rajp20/LED_Canvas/document/images/final_product.jpg

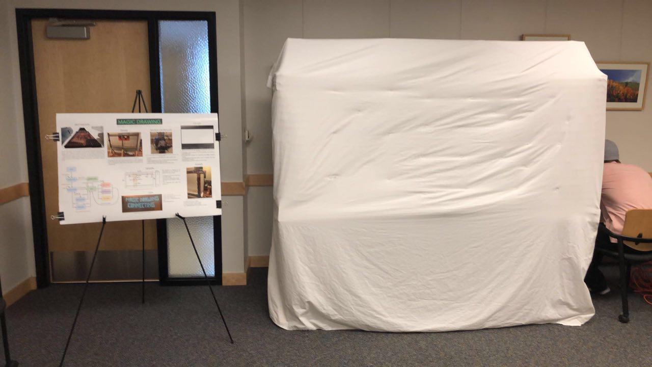
document/images/final_product.jpg
