rajp20/LED_Canvas/document/images/frame_updated.jpg

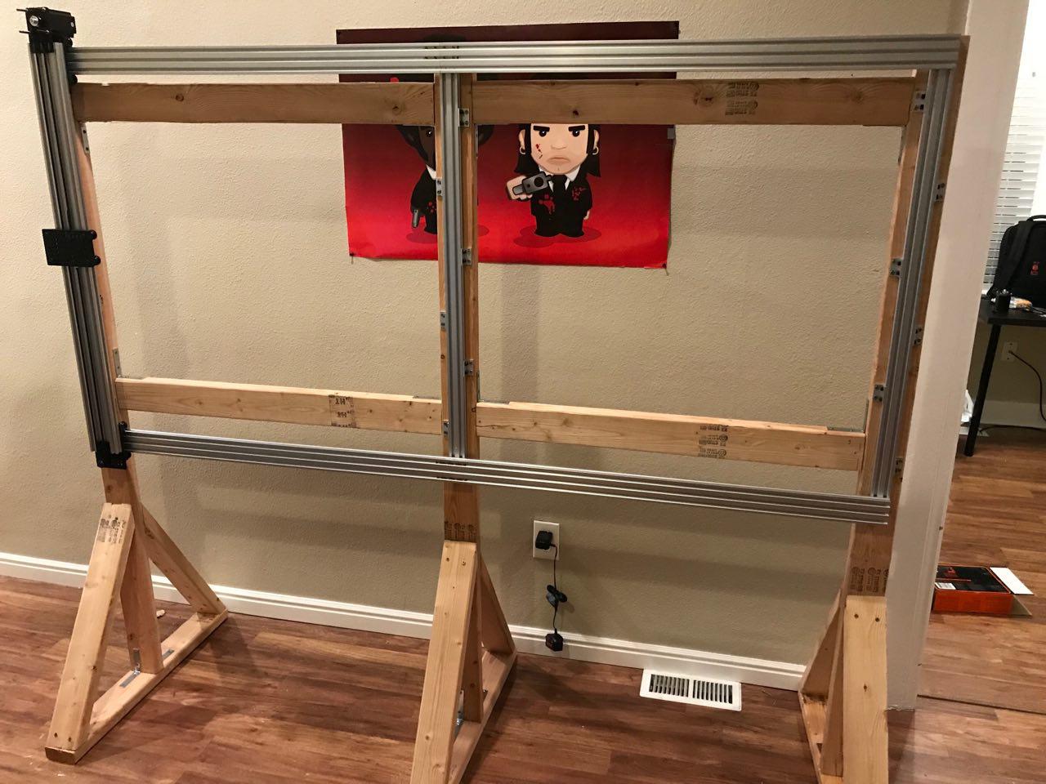
document/images/frame_updated.jpg
