rajp20/LED_Canvas/document/images/led_strips.jpg

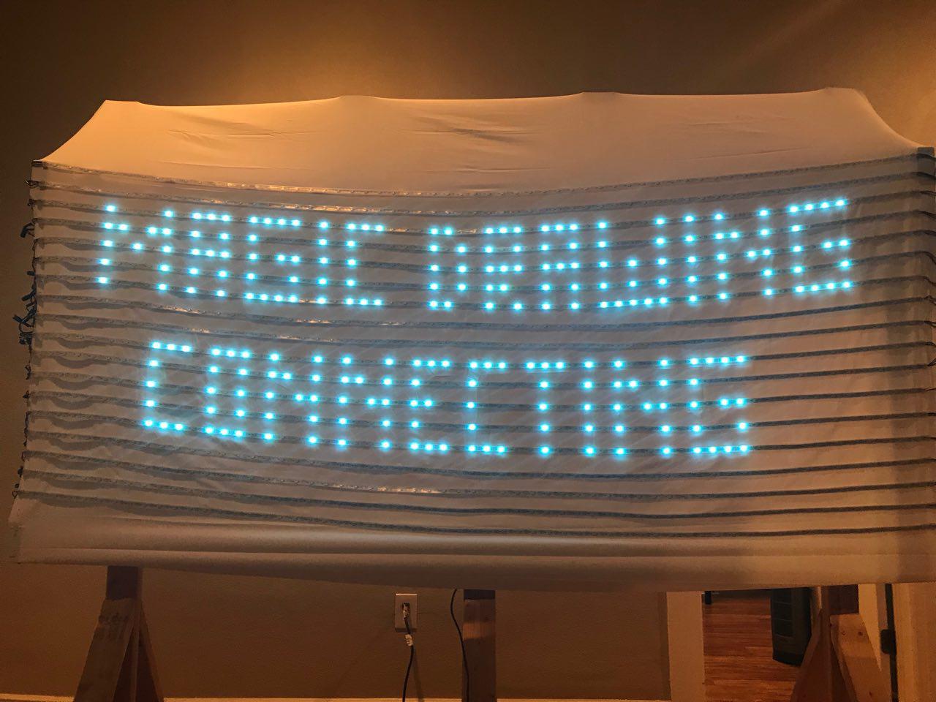
document/images/led_strips.jpg
