rajp20/LED_Canvas/document/images/state_diagram.png

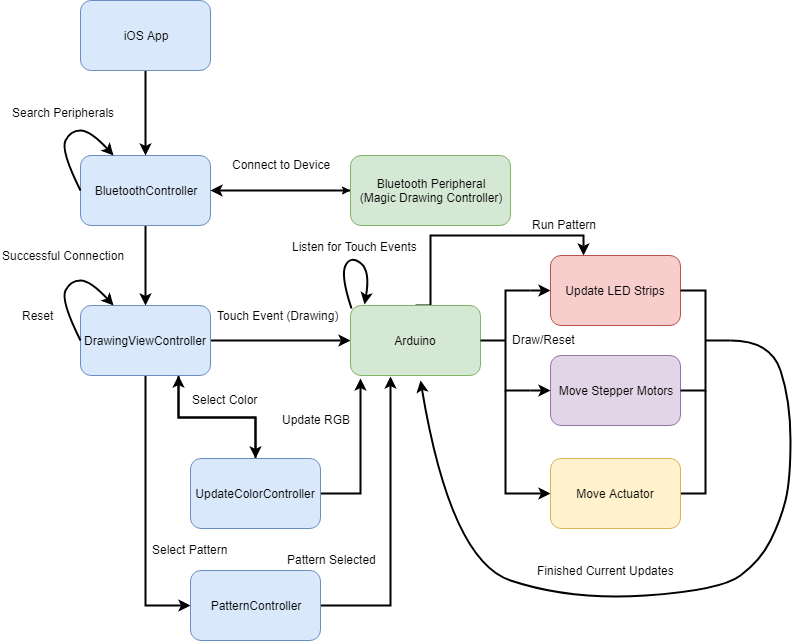
document/images/state_diagram.png
