rajp20/LED_Canvas/PCB_schematics/PCB_board.png

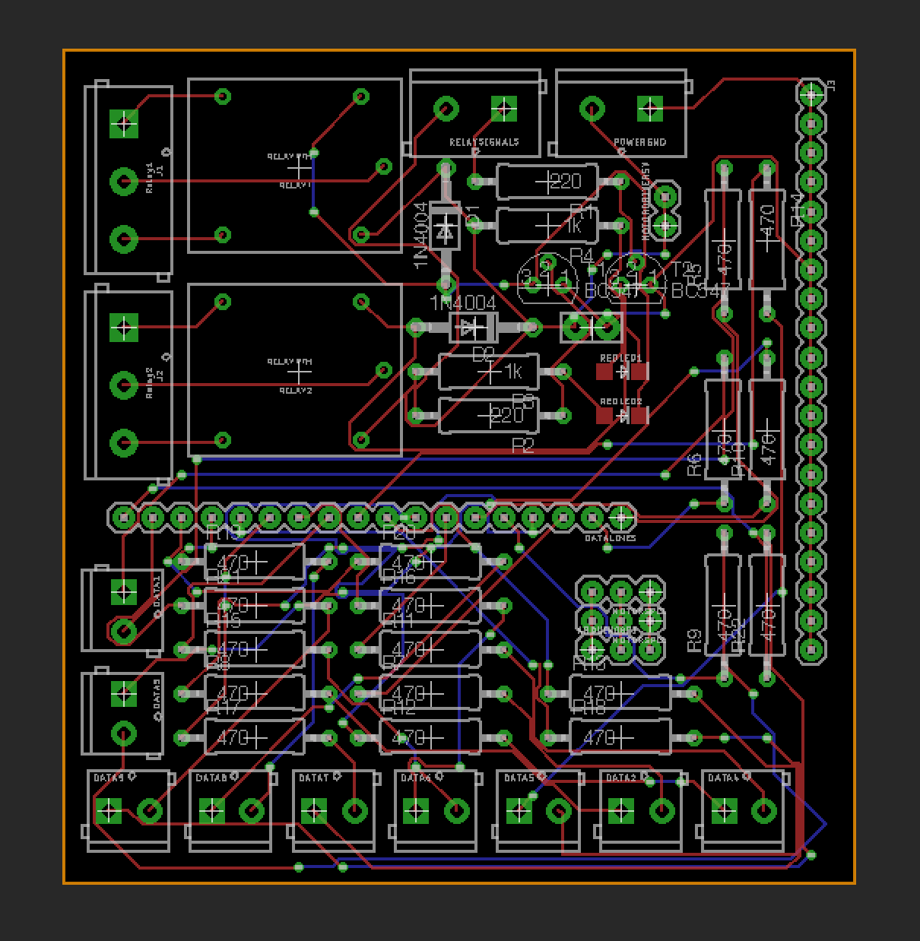
PCB_schematics/PCB_board.png
