rajp20/LED_Canvas/PCB_schematics/Connections and Power.brd

## EAGLE design PCB_schematics/Connections and Power.brd (2018-12-18)

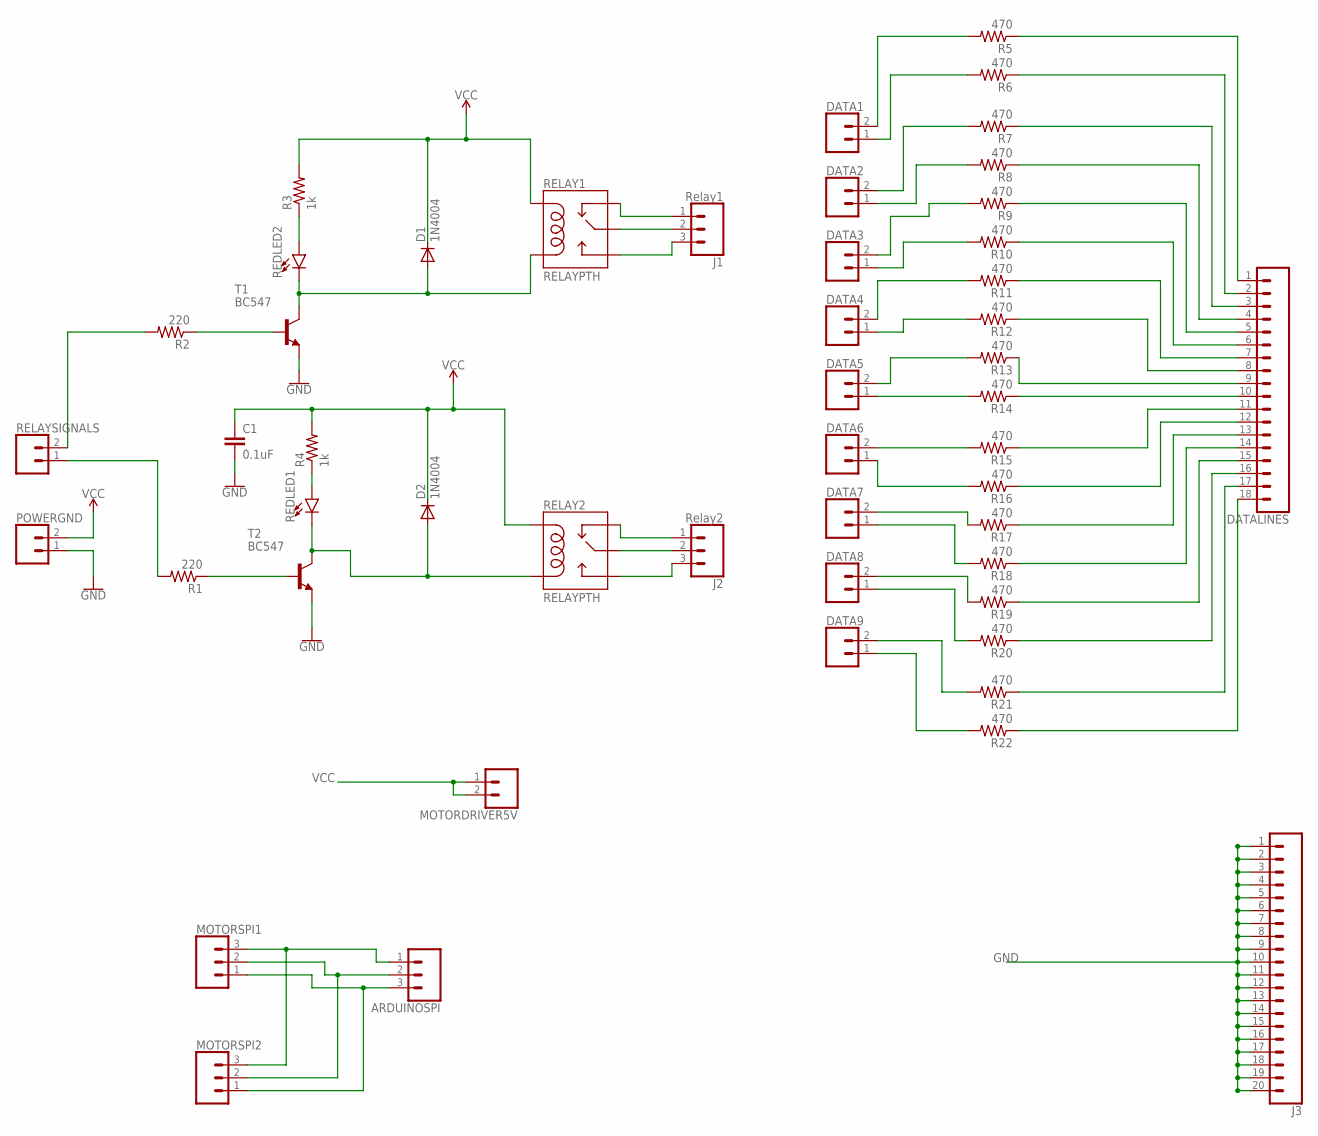
[picture p22: schematic Connections and Power.sch]

Parts:
ARDUINOSPI: CONN_03; 1X03
C1: 0.1uF; CAP-PTH-SMALL-KIT
D1, D2: 1N4004; DO41-10
DATA1, DATA2, DATA3, DATA4, DATA5, DATA6, DATA7, DATA8, DATA9: CONN_023.5MM; SCREWTERMINAL-3.5MM-2
DATALINES: CONN_18; 1X18
J1: Relay1; SCREWTERMINAL-5MM-3
J2: Relay2; SCREWTERMINAL-5MM-3
J3: CONN_20; 1X20
MOTORDRIVER5V: CONN_02; 1X02
MOTORSPI1, MOTORSPI2: CONN_03; 1X03
POWERGND: CONN_025MM; SCREWTERMINAL-5MM-2
R1, R2: 220; 0309/12
R3, R4: 1k; 0309/12
R5, R6, R7, R8, R9, R10, R11, R12, R13, R14, R15, R16, R17, R18, R19, R20, R21, R22: 470; 0309/12
REDLED1, REDLED2: LED1206; LED-1206
RELAY1, RELAY2: RELAYPTH; SRD-05VDC-SL-C
RELAYSIGNALS: CONN_025MM; SCREWTERMINAL-5MM-2
T1, T2: BC547; TO92

Connections:
GND: C1.2, J3.1, J3.2, J3.3, J3.4, J3.5, J3.6, J3.7, J3.8, J3.9, J3.10, J3.11, J3.12, J3.13, J3.14, J3.15, J3.16, J3.17, J3.18, J3.19, J3.20, POWERGND.1, T1.1 (E), T2.1 (E)
unnamed: DATA1.2, R5.2
unnamed: D2.A, REDLED1.C, RELAY2.COIL0, T2.3 (C)
unnamed: R4.1, REDLED1.A
unnamed: R2.2, RELAYSIGNALS.2
unnamed: J2.1, RELAY2.SWCLOSED (SWCLOSE)
unnamed: J2.2, RELAY2.SWCOMMON
unnamed: J2.3, RELAY2.SWOPEN
unnamed: R1.1, T2.2 (B)
unnamed: R2.1, T1.2 (B)
unnamed: D1.A, REDLED2.C, RELAY1.COIL0, T1.3 (C)
unnamed: R3.1, REDLED2.A
unnamed: DATA1.1, R6.2
unnamed: J1.1, RELAY1.SWCLOSED (SWCLOSE)
unnamed: J1.2, RELAY1.SWCOMMON
unnamed: J1.3, RELAY1.SWOPEN
unnamed: R1.2, RELAYSIGNALS.1
unnamed: DATA2.2, R7.2
unnamed: DATA2.1, R8.2
unnamed: DATA3.2, R9.2
unnamed: DATA3.1, R10.2
unnamed: DATA4.2, R11.2
unnamed: DATA4.1, R12.2
unnamed: DATA5.2, R13.2
unnamed: DATA5.1, R14.2
unnamed: DATA6.2, R15.2
unnamed: DATA6.1, R16.2
unnamed: DATA7.2, R17.2
unnamed: DATA7.1, R18.2
unnamed: DATA8.2, R19.2
unnamed: DATA8.1, R20.2
unnamed: DATA9.2, R21.2
unnamed: DATA9.1, R22.2
unnamed: DATALINES.18, R22.1
unnamed: DATALINES.17, R21.1
unnamed: DATALINES.16, R20.1
unnamed: DATALINES.15, R19.1
unnamed: DATALINES.14, R18.1
unnamed: DATALINES.13, R17.1
unnamed: DATALINES.12, R16.1
unnamed: DATALINES.11, R15.1
unnamed: DATALINES.10, R14.1
unnamed: DATALINES.1, R5.1
unnamed: DATALINES.2, R6.1
unnamed: DATALINES.3, R7.1
unnamed: DATALINES.4, R8.1
unnamed: DATALINES.5, R9.1
unnamed: DATALINES.6, R10.1
unnamed: DATALINES.7, R11.1
unnamed: DATALINES.8, R12.1
unnamed: DATALINES.9, R13.1
unnamed: ARDUINOSPI.1, MOTORSPI1.3, MOTORSPI2.3
unnamed: ARDUINOSPI.2, MOTORSPI1.2, MOTORSPI2.2
unnamed: ARDUINOSPI.3, MOTORSPI1.1, MOTORSPI2.1
VCC: C1.1, D1.C, D2.C, MOTORDRIVER5V.1, MOTORDRIVER5V.2, POWERGND.2, R3.2, R4.2, RELAY1.COIL1, RELAY2.COIL1

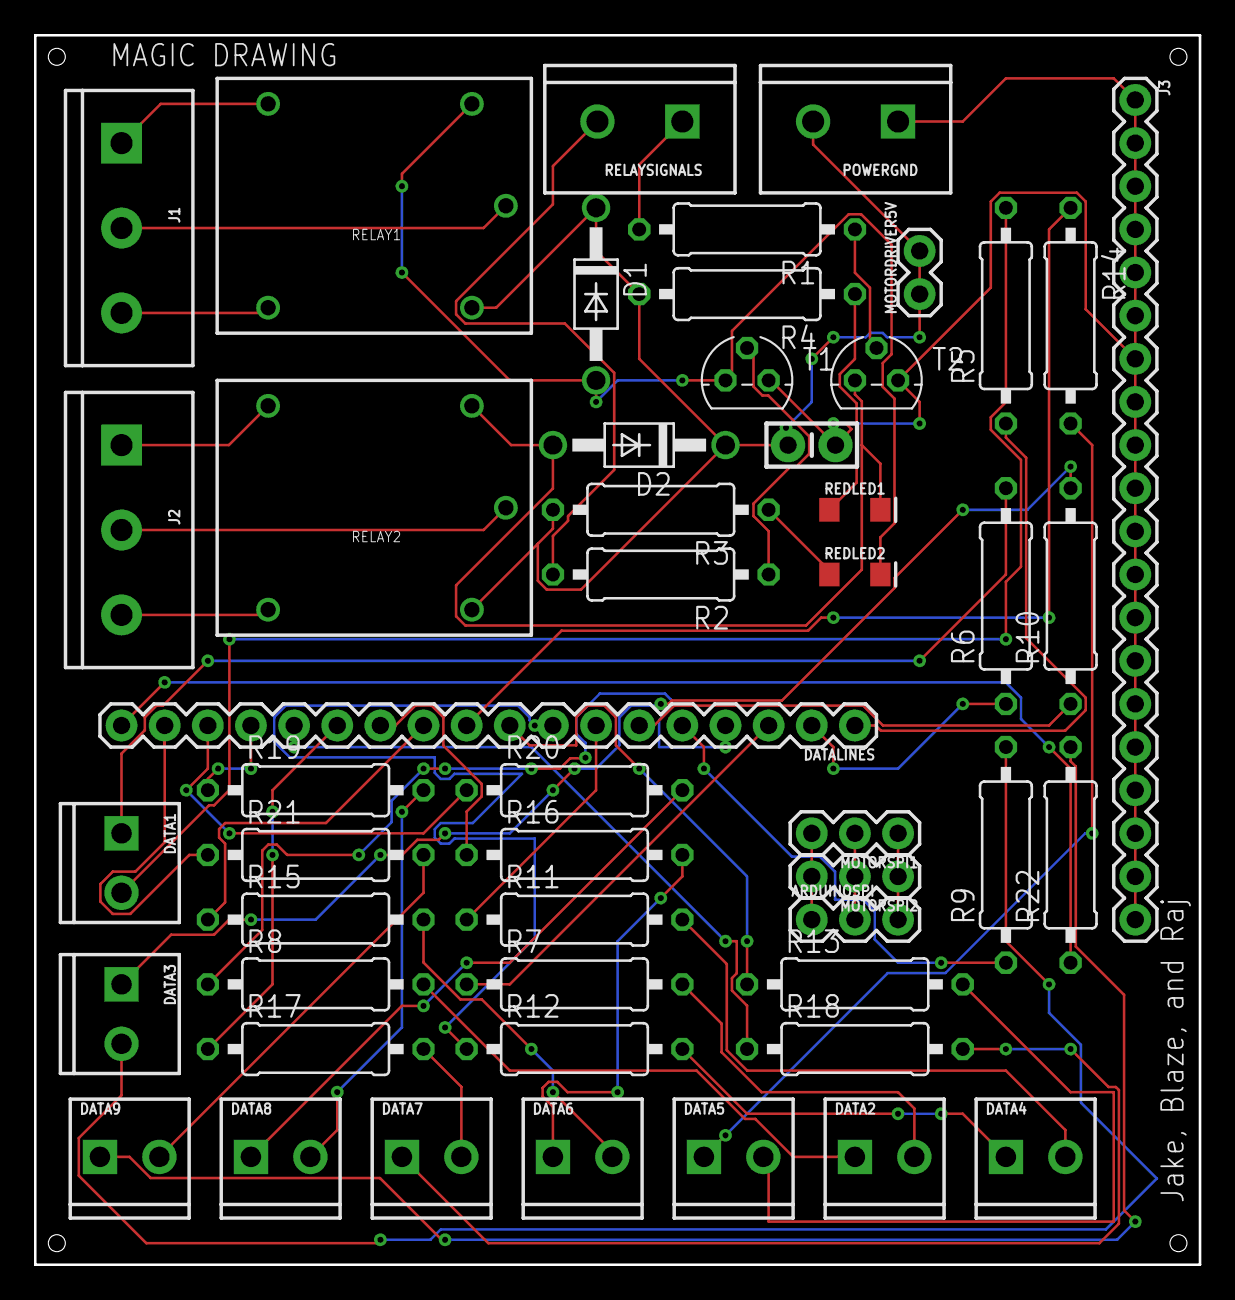
[picture p23: board Connections and Power.brd from above]

Board: 2 copper layers, 68.6 x 72.4 mm, 50 parts (0 on the bottom side), 55 nets.
