rajp20/LED_Canvas/Arduino/Uno_Motor/MotorController.ino

void MotorController::setup(void) {
  setupLimitSwitches();
  setupMotors();
  setupActuator();
  calibrate();
}

/**
   Sets up the X and Y limit switches pins.
*/
void MotorController::setupLimitSwitches(void) {
  pinMode(A0, INPUT);
  pinMode(A1, INPUT);
}

/**
   Sets up the pins for the actuator.
*/
void MotorController::setupActuator(void) {
  pinMode(ACTUATOR_UP, OUTPUT);
  pinMode(ACTUATOR_DOWN, OUTPUT);
  actuatorDown();
}

/**
   Configures the SPI connection and the motor settings for the X and Y motors.
*/
void MotorController::setupMotors(void) {
  SPI.begin();

  // Underlying motor initializiation
  x_motor.init(X_MOTOR_SLAVESELECT);
  y_motor.init(Y_MOTOR_SLAVESELECT);
  delay(1);

  // Drive the NXT/STEP and DIR pins low initially.
  digitalWrite(X_MOTOR_STEP, LOW);
  pinMode(X_MOTOR_STEP, OUTPUT);
  digitalWrite(X_MOTOR_DIR, LOW);
  pinMode(X_MOTOR_DIR, OUTPUT);

  digitalWrite(Y_MOTOR_STEP, LOW);
  pinMode(Y_MOTOR_STEP, OUTPUT);
  digitalWrite(Y_MOTOR_DIR, LOW);
  pinMode(Y_MOTOR_DIR, OUTPUT);

  x_motor.resetSettings();
  x_motor.setCurrentMilliamps(1800);
  x_motor.setStepMode(1);
  x_motor.enableDriver();

  y_motor.resetSettings();
  y_motor.setCurrentMilliamps(1800);
  y_motor.setStepMode(1);
  y_motor.enableDriver();
}

/**
   Bring the motors to home position. Also makes the actuator
   go up and down to check if it is working properly.
*/
void MotorController::calibrate(void) {
  setDirection(X_MOTOR, LEFT);
  setDirection(Y_MOTOR, UP);

  bool x_done = digitalRead(A0) == LOW;
  bool y_done = digitalRead(A1) == LOW;

  while (true) {
    
    if (!x_done) {
      step(X_MOTOR);
    }
    if (!y_done) {
      //      Serial.println("step y");
      step(Y_MOTOR);
    }
    x_done = digitalRead(A0) == LOW;
    y_done = digitalRead(A1) == LOW;
    if (x_done && y_done) {
      break;
    }
  }
  //  actuatorDown();
}

/**
   Sends a pulse on the NXT/STEP pin to tell the driver to take
   one step, and also delays to control the speed of the motor.
*/
void MotorController::step(bool motor)
{
  if (motor) {
    // The NXT/STEP minimum high pulse width is 2 microseconds.
    digitalWrite(X_MOTOR_STEP, HIGH);
    delayMicroseconds(3);
    digitalWrite(X_MOTOR_STEP, LOW);
    delayMicroseconds(3);
  }
  else {
    // The NXT/STEP minimum high pulse width is 2 microseconds.
    digitalWrite(Y_MOTOR_STEP, HIGH);
    delayMicroseconds(3);
    digitalWrite(Y_MOTOR_STEP, LOW);
    delayMicroseconds(3);
  }


  // The delay here controls the stepper motor's speed.  You can
  // increase the delay to make the stepper motor go slower.  If
  // you decrease the delay, the stepper motor will go fast, but
  // there is a limit to how fast it can go before it starts
  // missing steps.
  delayMicroseconds(1500);
}

/**
   Write a high or low value to the direction pin to specify
   what direction to turn the motor.
*/
// Writes a high or low value to the direction pin to specify
// what direction to turn the motor.
void MotorController::setDirection(bool motor, bool dir)
{
  if (motor) {
    // The NXT/STEP pin must not change for at least 0.5
    // microseconds before and after changing the DIR pin.
    delayMicroseconds(1);
    digitalWrite(X_MOTOR_DIR, dir);
    delayMicroseconds(1);
  }
  else {
    // The NXT/STEP pin must not change for at least 0.5
    // microseconds before and after changing the DIR pin.
    delayMicroseconds(1);
    digitalWrite(Y_MOTOR_DIR, dir);
    delayMicroseconds(1);
  }
}

/**
   Brings the actuator all the way out.
*/
void MotorController::actuatorUp(void) {
  digitalWrite(ACTUATOR_UP, HIGH);
  digitalWrite(ACTUATOR_DOWN, LOW);
}

/**
   Brings the actuator all the way in.
*/
void MotorController::actuatorDown(void) {
  digitalWrite(ACTUATOR_DOWN, HIGH);
  digitalWrite(ACTUATOR_UP, LOW);
}

/**
 * Stops the actuator from coming out or coming in
 */
void MotorController::stopActuator(void){
  digitalWrite(ACTUATOR_DOWN, LOW);
  digitalWrite(ACTUATOR_UP, LOW);
}

/*
  Move the motor to the new position
*/
void MotorController::move(int x, int y) {

  // Bound the x-axis
  if (x < 0) {
    x = 0;
  }
  if (x > 57) {
    x = 57;
  }

  // Bound the y-axis
  if (y < 0) {
    y = 0;
  }
  if (y > 17) {
    y = 17;
  }

  // Calculate the number of positions we need to move
  int numberOfXSteps = x - curX;
  int numberOfYSteps = y - curY;

  bool xDirection;
  bool yDirection;

  // Determine what direction the motors need to go
  if (numberOfXSteps < 0) {
    xDirection = LEFT;

    // Make it positive for next calculations
    numberOfXSteps *= -1;
  }
  else {
    xDirection = RIGHT;
  }

  if (numberOfYSteps < 0) {
    yDirection = UP;

    // Make it positive for next calculations
    numberOfYSteps *= -1;
  }
  else {
    yDirection = DOWN;
  }

  // Set the new directions
  setDirection(X_MOTOR, xDirection);
  setDirection(Y_MOTOR, yDirection);

  numberOfXSteps *= STEP_X;
  numberOfYSteps *= STEP_Y;


  while (numberOfXSteps > 0 ||  numberOfYSteps > 0) {
    if (numberOfXSteps > 0) {
      step(X_MOTOR);
      numberOfXSteps--;
    }
    if (numberOfYSteps > 0) {
      step(Y_MOTOR);
      numberOfYSteps--;
    }
  }

  curY = y;
  curX = x;

}
