rajp20/LED_Canvas/(commit log)

2018-09-13 Added Arduino project
2018-09-18 added led controller
2018-09-18 Added four buttons to toggle colors of leds
2018-10-23 Drawing view controller (UARTModuleViewController) now draws line segments
2018-11-03 Drawing view added and working with skip button on main
2018-11-03 added controller for motor
2018-11-03 BT now sending data at full capacity
2018-11-06 added 18 led strip config
2018-11-09 Added basic motor code.
2018-11-11 Began making custom class for menu bar at bottom of screen. Currently unable to connect UICollectionView to custom class
2018-11-24 Custom menu bar is now visible to the UARTModuleViewController
2018-11-25 Several ways in which MenuCell's can open options menu and will need to decide on one. Fixed clear button.
2018-11-25 working on motor class
2018-11-25 Created segue between UARTViewController and Color selction. Bugs exist between segue such as navigation bar disapears.
2018-11-25 updated motor controller
2018-11-26 added 'resetting' screen to LED controller and added ability to send packet to the iOS app.
    [BluetoothController.cpp, BluetoothController.h, LEDController.cpp, LEDController.h]
2018-11-26 Segues & corresponding view controllers added for Patterns and Filters
2018-11-27 Updates to labels, MenuCell padding, and reset button
2018-11-27 Added action to reset button on touch event. Apply button returns to UARTModuleViewController from ColorController
2018-11-28 fixed welcome and reset screens and added rainbow pixel test
    [Canvas.ino, LEDController.cpp, LEDController.h]
2018-11-30 added actuator stuff
2018-12-03 added led clearing
2018-12-03 motors calibrated
2018-12-03 Fixed draw ball I think.
    [LEDController.ino]
2018-12-04 updated LED controller
2018-12-05 Added images to the buttons in UARTModuleViewController
2018-12-05 Reset button works now.
2018-12-05 Pattern button for ball added
2018-12-05 Updated commands, added pattern buttons, tweaked resets. Bug remains in reset
2018-12-06 Fixed double connection errors.
    [BluetoothController.h, BluetoothController.ino, Canvas.ino]
2018-12-06 New button for Life pattern
2018-12-06 bug fixes, added fade to ripple, change conway, and added motor movement
    [Canvas.ino, LEDController.h, LEDController.ino, MotorController.ino]
2018-12-06 motors working, added drawBox for pixels, and added fade for draw
2018-12-07 UI updates, button configurations in PatternController
2018-12-07 bug fixes and removed interrupts
    [BluetoothController.ino, Canvas.ino, LEDController.h, LEDController.ino]
2018-12-18 Switched the MEGA and UNO code to different directories.
2018-12-18 PCB schematic files.
    [Connections and Power.brd, Connections and Power.sch]
